sssata/TBL/README.md

# Update: This project is now obsolete, superseded by https://github.com/sssata/HYKU_CAD.

# TBL - Tabletless

A SCARA arm based human input device for absolute mouse input.

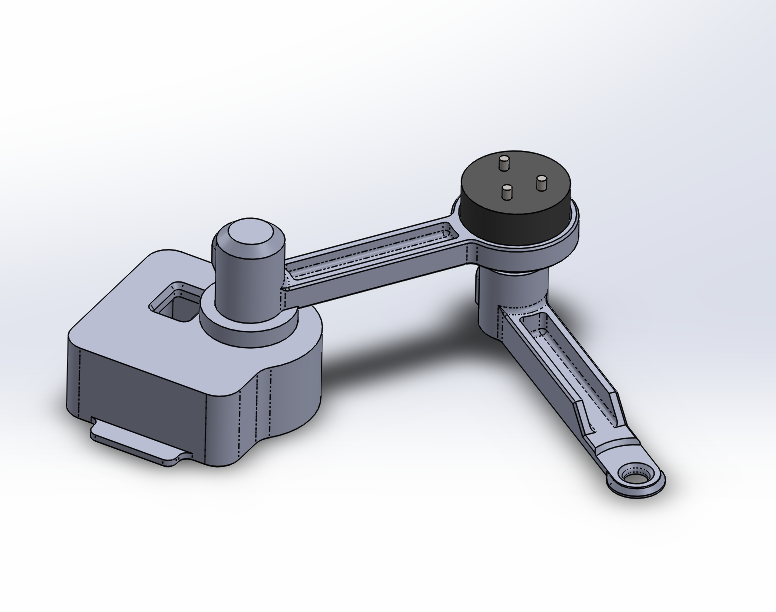
[picture p1: Images/CAD1.png]


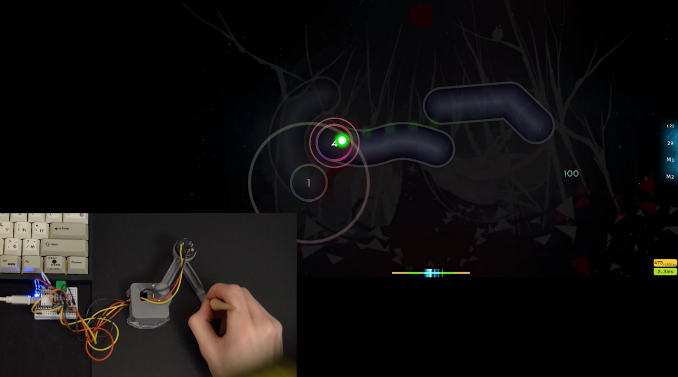
[picture p2: Images/osu1.png]


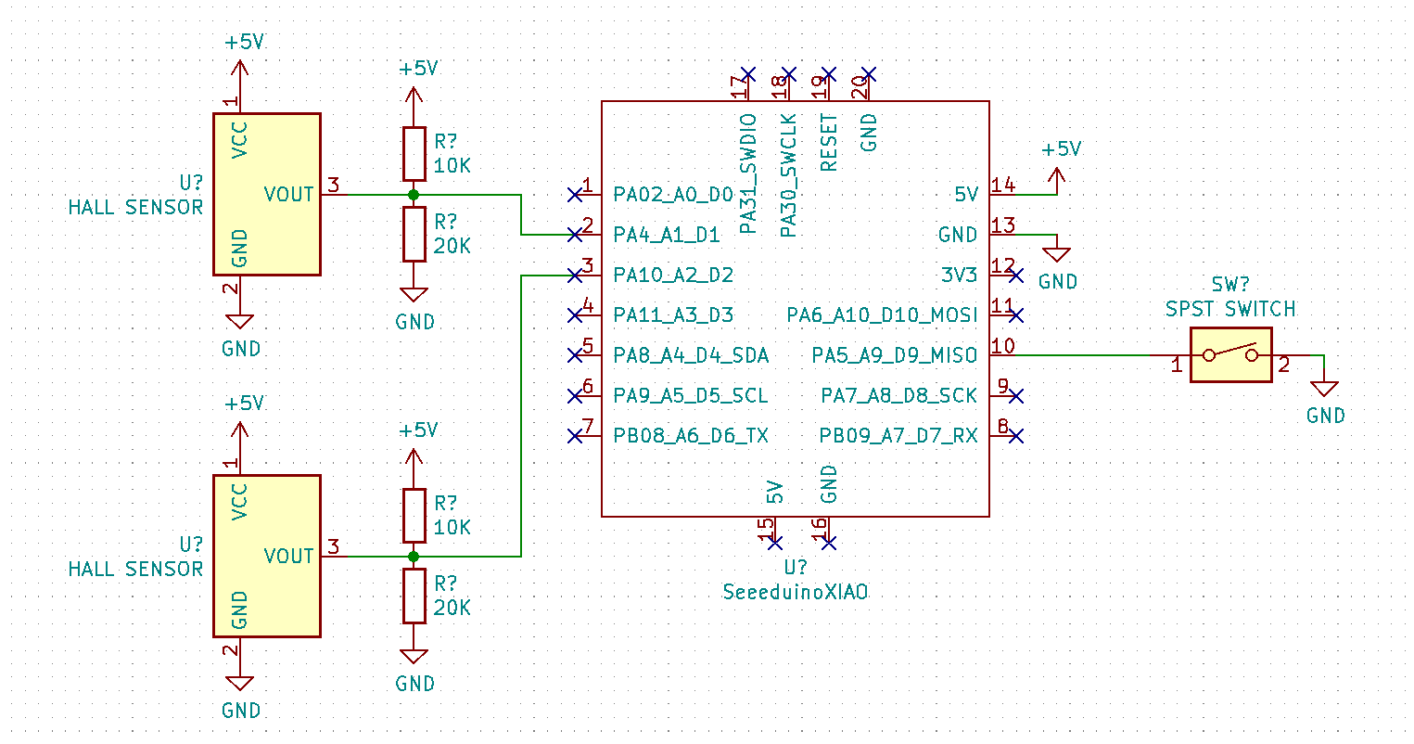
[picture p3: Images/wiring1.png]
