sssata/TBL/BOM.xlsx

DWG PART NUMBER | NAME | DESCRIPTION | QTY | DIGIKEY PART NUMBEER
001 | BASE | Base, 3D Printed | 1 | N/A
002 | UPPER ARM | Upper Arm, 3D Printed | 1 | N/A
003 | LOWER ARM | Lower Arm, 3D Printed | 1 | N/A
100 | ROTARY SENSOR | Hall Effect Sensor Rotary Position Flatted Shaft Solder Turret | 2 | 6127V1A180L.5FS
N/A | MCU | Seeeduino Xiao Microcontroller | 1 | 102010328
