sssata/TBL/CAD/TOP ASSEMBLY REV2.SLDASM

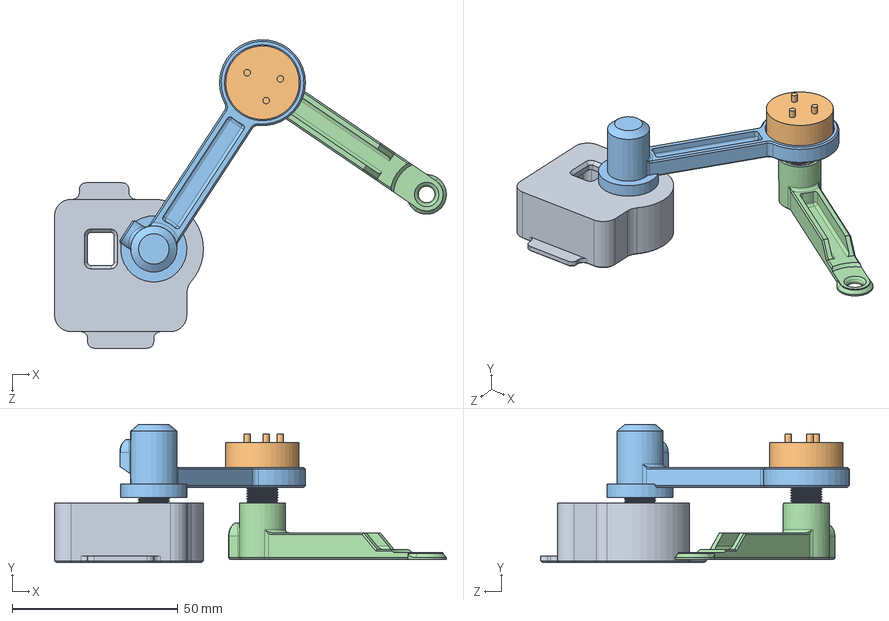
[picture p4: CAD file, 2021-04-20]
CAD/TOP ASSEMBLY REV2.SLDASM
118.4 x 41.7 x 93.2 mm
001 BASE REV2
100 ROTARY SENSOR REV1 x 2
002 UPPER ARM REV2
003 LOWER ARM REV2
