sssata/TBL/CAD/003 LOWER ARM REV2.SLDPRT

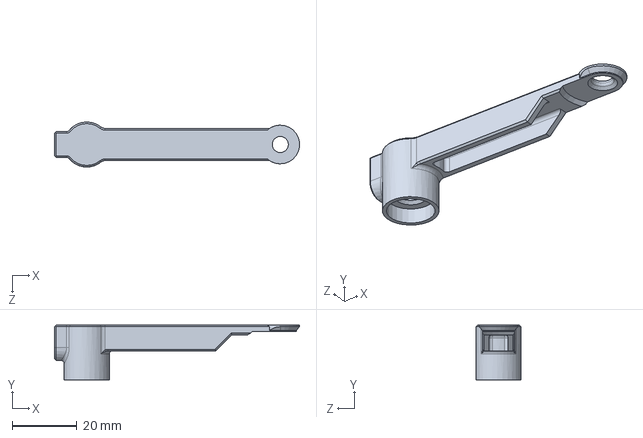
[picture p5: CAD file, 2021-04-20]
CAD/003 LOWER ARM REV2.SLDPRT
76.0 x 17.0 x 14.0 mm
