sssata/TBL/CAD/100 ROTARY SENSOR REV1.SLDPRT

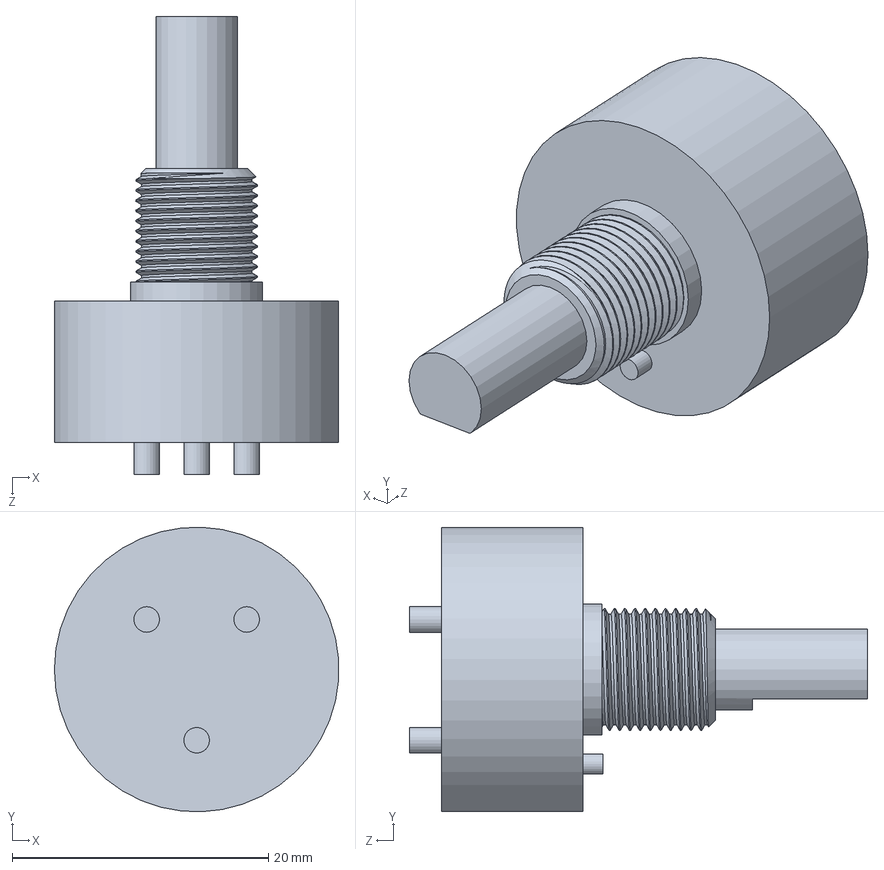
[picture p6: CAD file, 2021-04-20]
CAD/100 ROTARY SENSOR REV1.SLDPRT
22.2 x 22.2 x 35.8 mm
