sssata/TBL/CAD/002 UPPER ARM REV2.SLDPRT

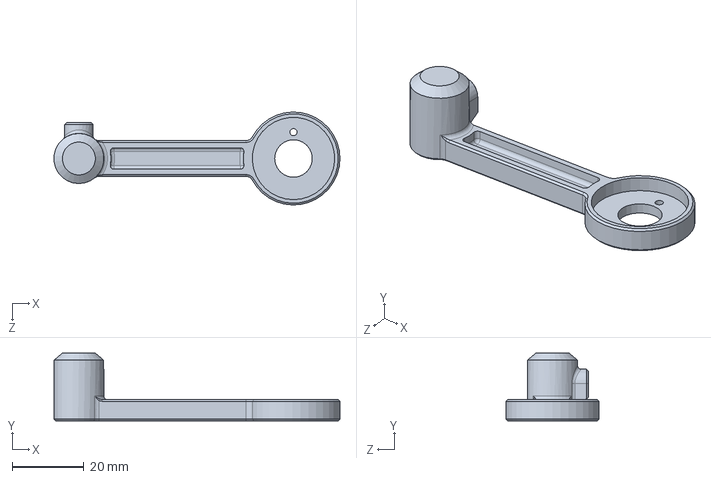
[picture p7: CAD file, 2021-04-20]
CAD/002 UPPER ARM REV2.SLDPRT
80.0 x 19.0 x 26.0 mm
