sssata/TBL/CAD/001 BASE REV2.SLDPRT

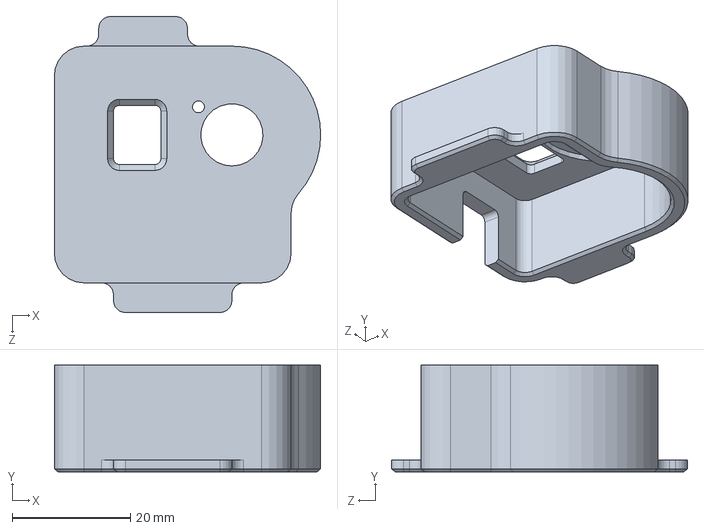
[picture p8: CAD file, 2021-04-20]
CAD/001 BASE REV2.SLDPRT
45.0 x 18.0 x 50.0 mm
