sssata/TBL/(list of files, cad)

Other CAD files:
CAD/STL/001 BASE REV2.STL
CAD/STL/002 UPPER ARM REV2.STL
CAD/STL/003 LOWER ARM REV2.STL
